Skuzee/ESS-Adapter/(list of files, drawings)

Other design files:
ESS-Adapter/src/Nintendo/extras/Gamecube.fzz
