Skuzee/ESS-Adapter/(commit log)

2019-11-03 changed local variable reference, added pin 13 debug/status light.
2019-12-03 arranged files/folders to work with arduio ide, added wiring info and comments, added nintendo library version guard
2019-12-03 messed up mv
    [Gamecube.fzz]
2019-12-03 fixed typo, updated readme.
    [ESS-Adapter.ino]
2019-12-21 fixed comments and error messages and wiring diagram accuracy
    [ESS-Adapter.ino]
2020-01-25 Powering the arduino via the Vin pin is the safest solution. You can power it via the 5v pin ONLY if your USB Bus voltage is protected by a diode or regulator.
2020-03-08 Added NintendoSpy Input Display support. Requires specail nintendospy version to work with some arduino like the pro micro, but should work for an UNO
2020-03-21 I uploaded a WIP code and buggered up git trying to fix it. made it worse....
    [ESS-Adapter.ino, Nintendo.h]
2020-03-21 I uploaded a WIP code and buggered up git trying to fix it. made it worse.... oops this one works for me. input display disabled by default
    [ESS-Adapter.ino]
2020-05-30 Updated schematic with nicer version and added protection diode, updated readme
2020-05-31 updated GC schematic and readme
2021-02-18 Replaced Nintendo files with submodule of Nintendo repo
    [Gamecube.fzz]
2021-02-18 Revert "Replaced Nintendo files with submodule of Nintendo repo"
    This reverts commit 17423c17ff9579b29b60f214ee5e11893a9df78a.
    [Gamecube.fzz]
2021-02-18 trying to remove tracking of nintendo lib to manage seperately
    [Gamecube.fzz]
2021-02-18 Messing with nintendo lib
    [Gamecube.fzz]
2021-03-01 Fixed Input Display Stutter, Added failed read counter and automatic re-connect, Program now auto connects to either n64 or gc controller and runs appropriate commands.
    [ESS-Adapter.ino, ESS.cpp, extra.cpp, extra.hpp, input-display.cpp]
2021-03-03 more eeprom loading/saving features and beginning of button combo menu
2021-06-21 Changed how connecting/disconnecting is handled. automatically connects to either n64 or gc controller. added settings menu with button combos. added eeprom save feature to load and store settings. a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
    [ESS-Adapter.ino, ESS.cpp, ESS.hpp, extra.cpp, extra.hpp, input-display.cpp]
2021-06-27 Variable read delay. will implement an auto-read-delay function to support different game with different controller polling timings. Merged changeSettings_GC an changeSettings_N64 Working on rumble m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
    [ESS-Adapter.ino, ESS.cpp, ESS.hpp, extra.cpp, extra.hpp, input-display.cpp, input-display.hpp]
2021-11-11 Finishing touches before merging/replacing master with current dev1 branch!!!
2021-11-12 added debug for temp for timing validation analysis. Fixed error with read delay. oops.
    [ESS-Adapter.ino, extra.cpp, extra.hpp]
2021-11-13 fixed yoshi button map. fixed bug in indicatiorLights
    [ESS-Adapter.ino, ESS.cpp, extra.cpp, extra.hpp]
2021-12-03 fixed centering and max values of cstick & left/right trigger. minor thing.
    [ESS.cpp]
2022-05-07 Added vibration feature for navigating settings menu. short = off, long = on pulses: 1 = oot, 2 = yoshi story, 3 = generic n64 map (only effects n64 button maps)
    [ESS-Adapter.ino, extra.cpp, extra.hpp]
2022-06-03 Slight change to how controller pins are defined and how controllers are intialized. Support for single data pin or dual data pin designs.
2022-06-25 fixed n64 input display range bug.
    [ESS-Adapter.ino]
